Jebonicus/JebSolarManager/images/panels_fitted.JPEG

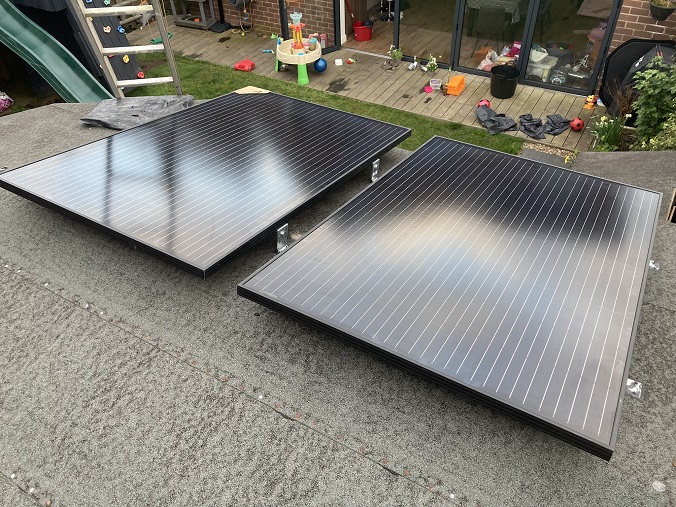
images/panels_fitted.JPEG
